EPCN-fla/F2MC-8FX-Programmer/diagram/F2MC-LINK_v1.1.pdf

# USB

# TYPE-C

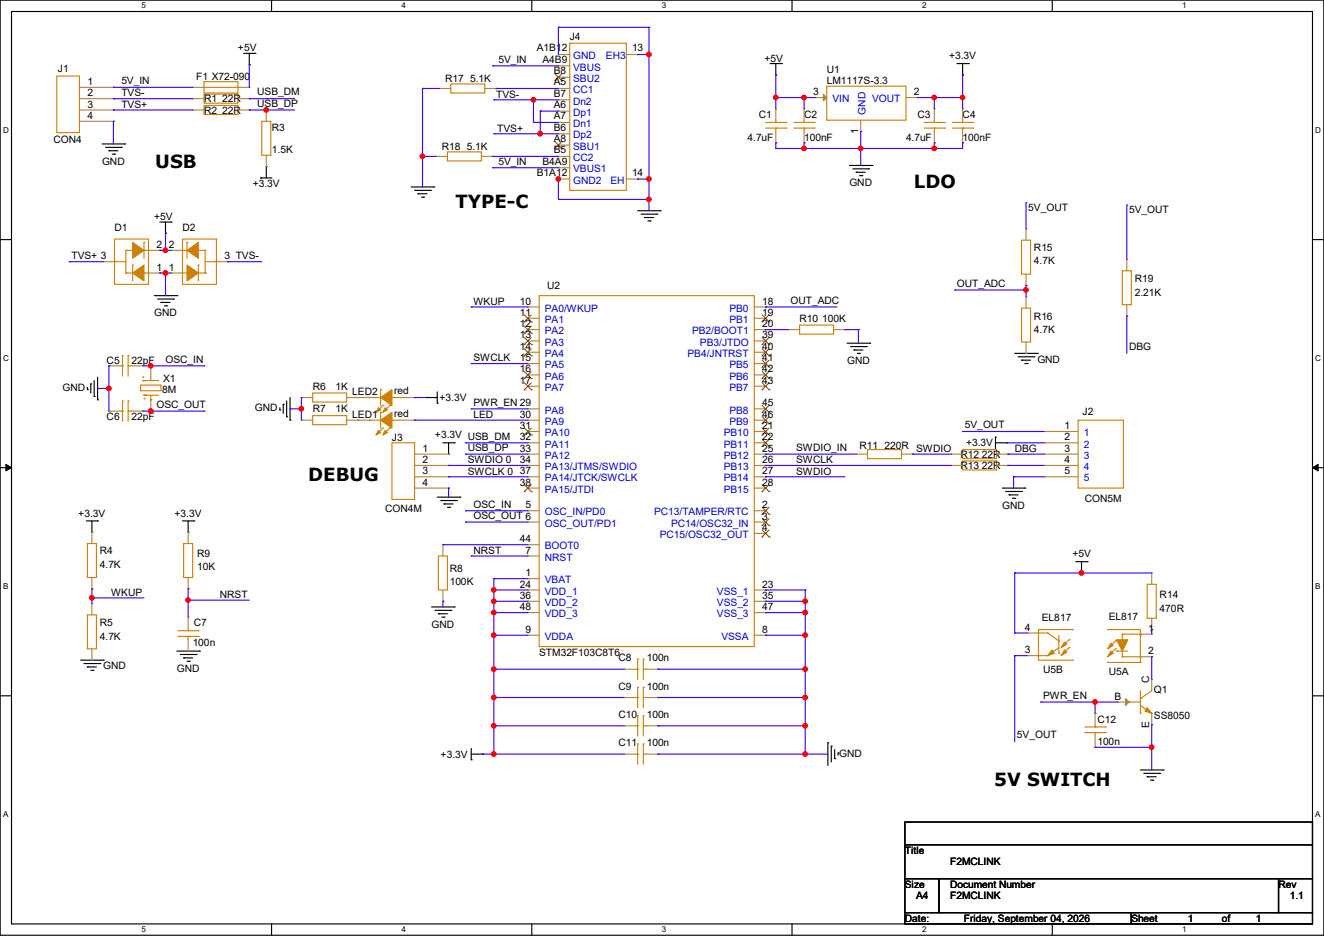
[picture p1: page 1]
