EPCN-fla/F2MC-8FX-Programmer/firmware/Core/Inc/main.h

#define SWCLK_BK_Pin GPIO_PIN_5
#define SWCLK_BK_GPIO_Port GPIOA
#define VCC_DETECT_Pin GPIO_PIN_0
#define VCC_DETECT_GPIO_Port GPIOB
#define SWDIO_IN_Pin GPIO_PIN_12
#define SWDIO_IN_GPIO_Port GPIOB
#define SWDIO_IN_EXTI_IRQn EXTI15_10_IRQn
#define SWCLK_Pin GPIO_PIN_13
#define SWCLK_GPIO_Port GPIOB
#define SWDIO_OUT_Pin GPIO_PIN_14
#define SWDIO_OUT_GPIO_Port GPIOB
#define PWR_EN_Pin GPIO_PIN_8
#define PWR_EN_GPIO_Port GPIOA
#define LED_Pin GPIO_PIN_9
#define LED_GPIO_Port GPIOA
