EPCN-fla/F2MC-8FX-Programmer/firmware/Core/Src/main.c

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
/* Includes ------------------------------------------------------------------*/
#include "main.h"
#include "adc.h"
#include "usb_device.h"
#include "gpio.h"

/* USER CODE BEGIN Includes */
#include <rtthread.h>
extern int rtthread_startup(void);   /* RT-Thread/board.c 提供 */
/* USER CODE END Includes */


void SystemClock_Config(void);
/**
  * @brief  The application entry point.
  * @retval int
  */
int main(void)
{

  /* USER CODE BEGIN 1 */
  /* ⚠ 关键：HAL_Init 会立即使能 SysTick 中断，而 pack 的 SysTick_Handler
   * (bsp/_template/cubemx_config/board.c) 中 rt_tick_increase() 会解引用
   * rt_current_thread——调度器启动前其为 NULL，必然 HardFault。
   * 故在 HAL_Init 之前屏蔽全局中断；MX_* 初始化均不依赖中断（USB 枚举可等待）。
   * rtthread_startup() 首次上下文切换时由 context_gcc.S 的 CPSIE I 恢复中断，
   * 此时 rt_current_thread 已有效。 */
  __disable_irq();
  /* USER CODE END 1 */

  /* MCU Configuration--------------------------------------------------------*/

  /* Reset of all peripherals, Initializes the Flash interface and the Systick. */
  HAL_Init();

  /* Configure the system clock */
  SystemClock_Config();

  /* Initialize all configured peripherals */
  MX_GPIO_Init();
  MX_ADC1_Init();
  MX_USB_DEVICE_Init();
  /* USER CODE BEGIN 2 */
  /* RT-Thread Nano 启动（不返回）：board.c rt_hw_board_init() →
   * App/prog_tasks.c rt_application_init() → 启动调度器 */
  rtthread_startup();
  /* USER CODE END 2 */

  /* Infinite loop */
  /* USER CODE BEGIN WHILE */
  while (1)
  {
    /* USER CODE END WHILE */

    /* USER CODE BEGIN 3 */
  }
  /* USER CODE END 3 */
}

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
