EPCN-fla/F2MC-8FX-Programmer/(commit log)

2026-09-05 [v0.1.0] 初次提交
    [896.csv, f2mc-target.cfg, probe-f2mc.cfg, stm32f1x-burn.cfg]
2026-09-08 docs: 新增官方文档
2026-09-08 refactor: 更新 Download Agent (DA)
    实测旧版 DA 无法烧录 MB95F698K，替换此版正常
2026-09-08 refactor: 更新兼容版本复位模式（断电+上电模拟）
2026-09-08 chore: 版本号升级至 0.2.0
2026-09-08 chore: 更新 git 排除项
2026-09-08 fix: 修复 Flash 有效区间描述
    [chipdef.rs]
2026-09-08 feat: 新增 单片机型号下发 & 烧录恢复
2026-09-08 test: 新增烧录恢复测试
2026-09-08 style: 更新注释
2026-09-08 docs: 更新说明文档与通信协议参数
2026-09-08 docs: 新增 DA 结构解析文档
2026-09-08 docs: 更新 README.md
